peteallenm/edrumulus/hardware/prototype_petea_smd/edrumulus.kicad_pcb

## KiCad design hardware/prototype_petea_smd/edrumulus.kicad_pcb (2024-10-21)

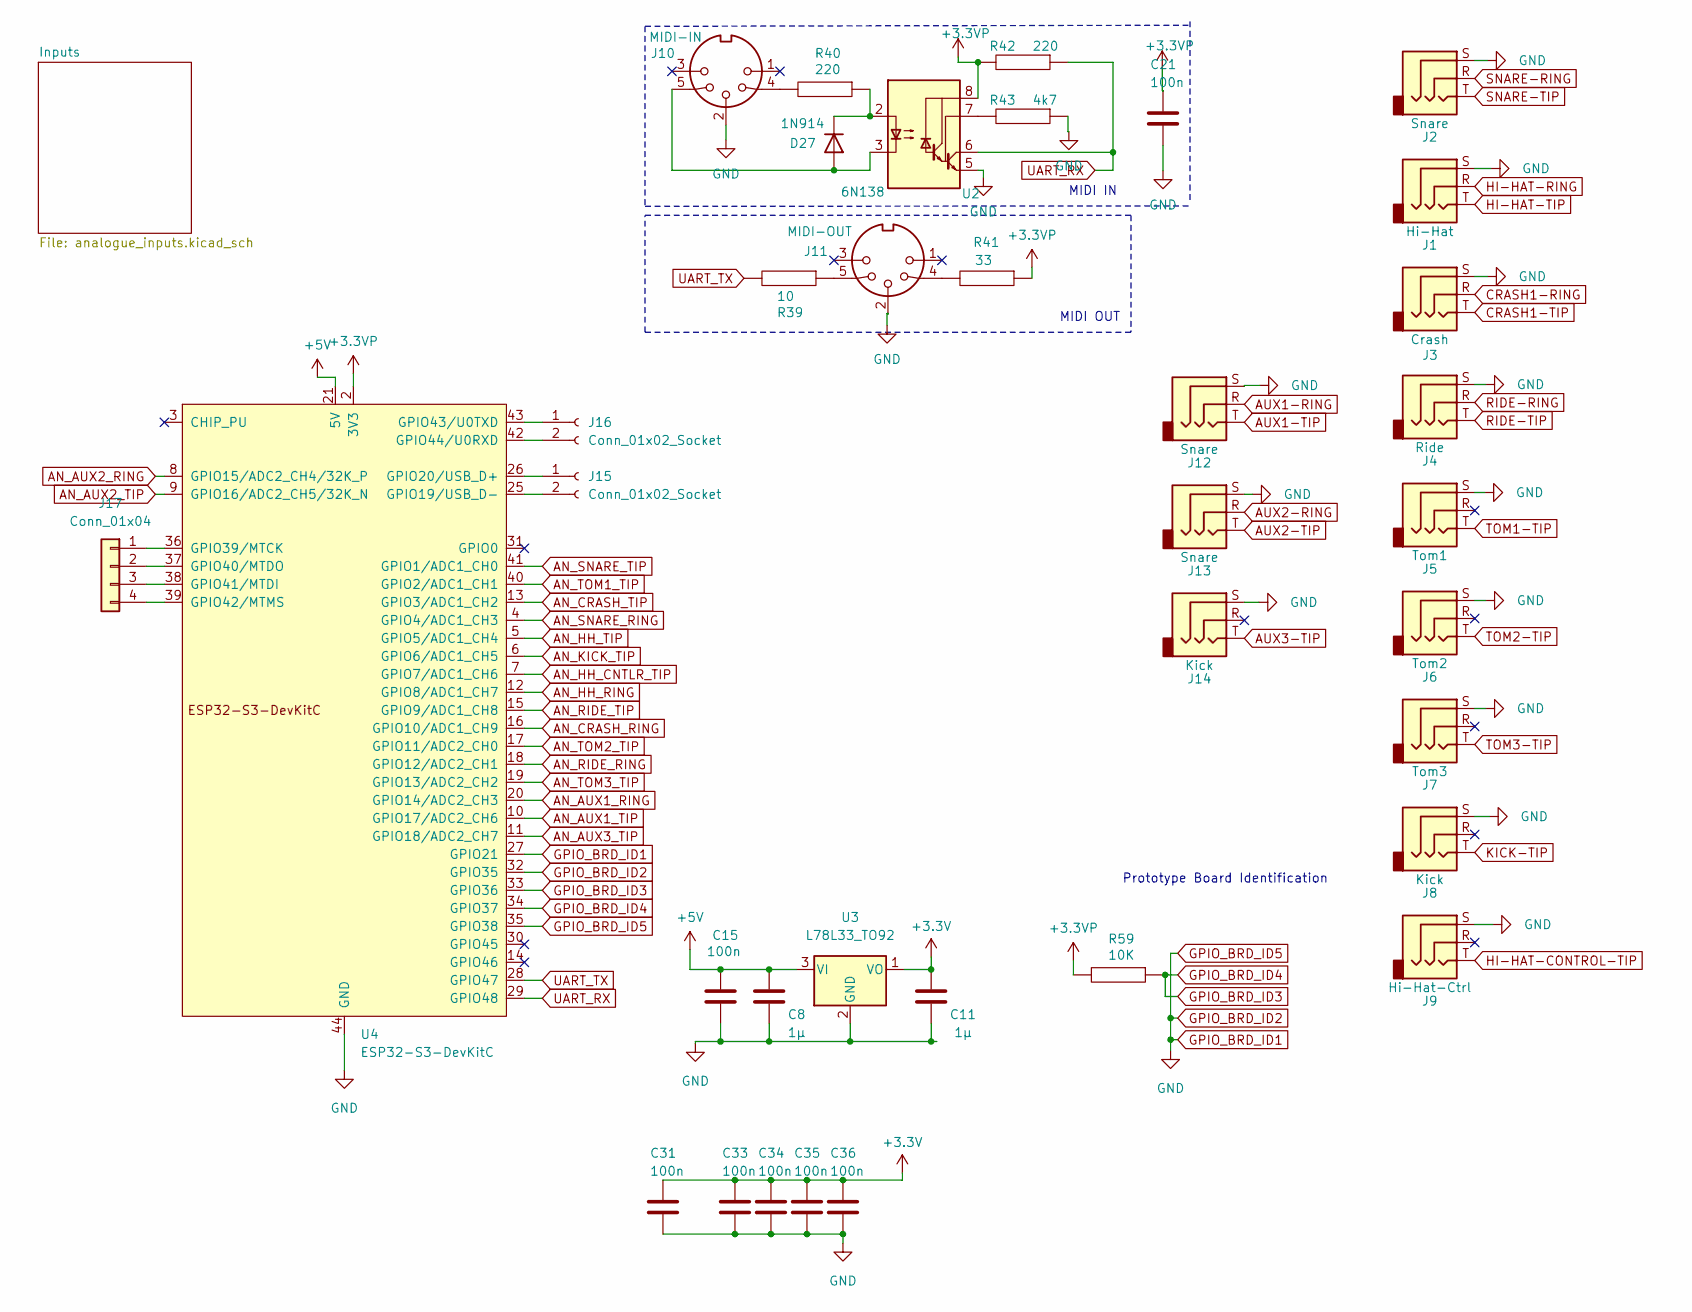
[picture p1: schematic edrumulus.kicad_sch, Edrumulus Prototype 7 (ESP32 S3)]

Parts:
C8, C11: 1µ; C_1206_3216Metric
C15, C21, C31, C33, C34, C35, C36: 100n; C_1206_3216Metric
D27: 1N914; D_DO-35_SOD27_P7.62mm_Horizontal
J1: Hi-Hat; Jack_6.35mm_Neutrik_NMJ6HCD2_Horizontal
J2, J12, J13: Snare; Jack_6.35mm_Neutrik_NMJ6HCD2_Horizontal
J3: Crash; Jack_6.35mm_Neutrik_NMJ6HCD2_Horizontal
J4: Ride; Jack_6.35mm_Neutrik_NMJ6HCD2_Horizontal
J5: Tom1; Jack_6.35mm_Neutrik_NMJ6HCD2_Horizontal
J6: Tom2; Jack_6.35mm_Neutrik_NMJ6HCD2_Horizontal
J7: Tom3; Jack_6.35mm_Neutrik_NMJ6HCD2_Horizontal
J8, J14: Kick; Jack_6.35mm_Neutrik_NMJ6HCD2_Horizontal
J9: Hi-Hat-Ctrl; Jack_6.35mm_Neutrik_NMJ6HCD2_Horizontal
J10: MIDI-IN; DIN-5
J11: MIDI-OUT; DIN-5
J15, J16: Conn_01x02_Socket; PinHeader_1x02_P2.54mm_Vertical
J17: Conn_01x04; PinHeader_1x04_P2.54mm_Vertical
R39: 10; R_1206_3216Metric
R40, R42: 220; R_1206_3216Metric
R41: 33; R_1206_3216Metric
R43: 4k7; R_1206_3216Metric
R59: 10K; R_1206_3216Metric
U2: 6N138; DIP-8_W7.62mm_Socket
U3: L78L33_TO92; TO-92_Inline
U4: ESP32-S3-DevKitC

Connections:
+3.3V: C11.1, C31.1, C33.1, C34.1, C35.1, C36.1, U3.1 (VO); also elsewhere on the board
+3.3VP: C21.1, R41.1, R42.2, R59.2, U2.8 (VCC), U4.1 (3V3), U4.2 (3V3)
+5V: C8.1, C15.1, U3.3 (VI), U4.21 (5V)
AN_AUX1_RING: U4.20 (GPIO14/ADC2_CH3); also elsewhere on the board
AN_AUX1_TIP: U4.10 (GPIO17/ADC2_CH6); also elsewhere on the board
AN_AUX2_RING: U4.8 (GPIO15/ADC2_CH4/32K_P); also elsewhere on the board
AN_AUX2_TIP: U4.9 (GPIO16/ADC2_CH5/32K_N); also elsewhere on the board
AN_AUX3_TIP: U4.11 (GPIO18/ADC2_CH7); also elsewhere on the board
AN_CRASH_RING: U4.16 (GPIO10/ADC1_CH9); also elsewhere on the board
AN_CRASH_TIP: U4.13 (GPIO3/ADC1_CH2); also elsewhere on the board
AN_HH_CNTLR_TIP: U4.7 (GPIO7/ADC1_CH6); also elsewhere on the board
AN_HH_RING: U4.12 (GPIO8/ADC1_CH7); also elsewhere on the board
AN_HH_TIP: U4.5 (GPIO5/ADC1_CH4); also elsewhere on the board
AN_KICK_TIP: U4.6 (GPIO6/ADC1_CH5); also elsewhere on the board
AN_RIDE_RING: U4.18 (GPIO12/ADC2_CH1); also elsewhere on the board
AN_RIDE_TIP: U4.15 (GPIO9/ADC1_CH8); also elsewhere on the board
AN_SNARE_RING: U4.4 (GPIO4/ADC1_CH3); also elsewhere on the board
AN_SNARE_TIP: U4.41 (GPIO1/ADC1_CH0); also elsewhere on the board
AN_TOM1_TIP: U4.40 (GPIO2/ADC1_CH1); also elsewhere on the board
AN_TOM2_TIP: U4.17 (GPIO11/ADC2_CH0); also elsewhere on the board
AN_TOM3_TIP: U4.19 (GPIO13/ADC2_CH2); also elsewhere on the board
AUX1-RING: J12.R; also elsewhere on the board
AUX1-TIP: J12.T; also elsewhere on the board
AUX2-RING: J13.R; also elsewhere on the board
AUX2-TIP: J13.T; also elsewhere on the board
AUX3-TIP: J14.T; also elsewhere on the board
CRASH1-RING: J3.R; also elsewhere on the board
CRASH1-TIP: J3.T; also elsewhere on the board
GPIO_BRD_ID1: C8.2, C11.2, C15.2, C21.2, C31.2, C33.2, C34.2, C35.2, C36.2, J1.S, J2.S, J3.S, J4.S, J5.S, J6.S, J7.S, J8.S, J9.S, J10.2, J11.2, J12.S, J13.S, J14.S, R43.1, U2.5 (GND), U3.2 (GND), U4.22 (GND), U4.23 (GND), U4.24 (GND), U4.27 (GPIO21), U4.32 (GPIO35), U4.35 (GPIO38), U4.44 (GND); also elsewhere on the board
GPIO_BRD_ID3: R59.1, U4.33 (GPIO36), U4.34 (GPIO37)
HI-HAT-CONTROL-TIP: J9.T; also elsewhere on the board
HI-HAT-RING: J1.R; also elsewhere on the board
HI-HAT-TIP: J1.T; also elsewhere on the board
KICK-TIP: J8.T; also elsewhere on the board
unnamed: D27.2 (A), J10.5, U2.3 (C2)
unnamed: D27.1 (K), R40.1, U2.2 (C1)
unnamed: J10.4, R40.2
unnamed: J11.4, R41.2
unnamed: J11.5, R39.1
unnamed: J15.1, U4.26 (GPIO20/USB_D+)
unnamed: J15.2, U4.25 (GPIO19/USB_D-)
unnamed: J16.1, U4.43 (GPIO43/U0TXD)
unnamed: J16.2, U4.42 (GPIO44/U0RXD)
unnamed: J17.1, U4.36 (GPIO39/MTCK)
unnamed: J17.2, U4.37 (GPIO40/MTDO)
unnamed: J17.3, U4.38 (GPIO41/MTDI)
unnamed: J17.4, U4.39 (GPIO42/MTMS)
unnamed: R43.2, U2.7 (VO1)
RIDE-RING: J4.R; also elsewhere on the board
RIDE-TIP: J4.T; also elsewhere on the board
SNARE-RING: J2.R; also elsewhere on the board
SNARE-TIP: J2.T; also elsewhere on the board
TOM1-TIP: J5.T; also elsewhere on the board
TOM2-TIP: J6.T; also elsewhere on the board
TOM3-TIP: J7.T; also elsewhere on the board
UART_RX: R42.1, U2.6 (VO2), U4.29 (GPIO48)
UART_TX: R39.2, U4.28 (GPIO47)

Notes on the sheet:
MIDI OUT
Prototype Board Identification
MIDI IN

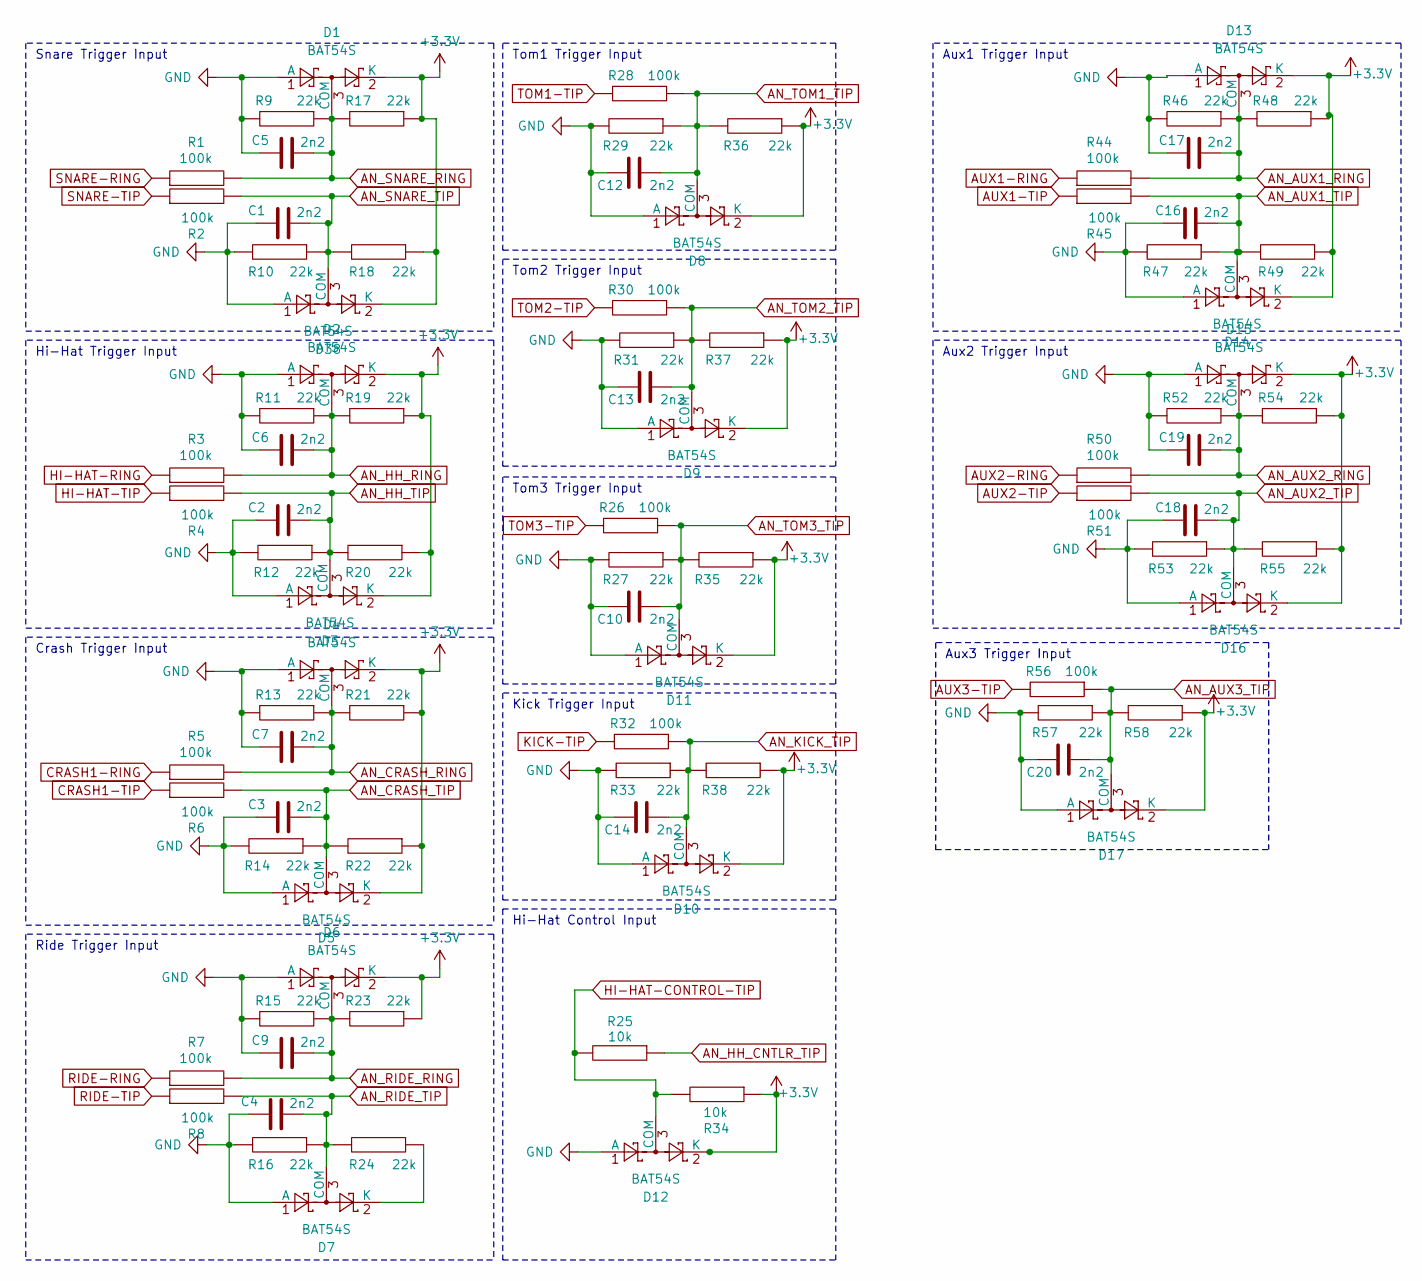
[picture p2: schematic analogue_inputs.kicad_sch]

Parts:
C1, C2, C3, C4, C5, C6, C7, C9, C10, C12, C13, C14, C16, C17, C18, C19, C20: 2n2; C_1206_3216Metric
D1, D2, D3, D4, D5, D6, D7, D8, D9, D10, D11, D12, D13, D14, D15, D16, D17, D38: BAT54S; SOT-23
R1, R2, R3, R4, R5, R6, R7, R8, R26, R28, R30, R32, R44, R45, R50, R51, R56: 100k; R_1206_3216Metric
R9, R10, R11, R12, R13, R14, R15, R16, R17, R18, R19, R20, R21, R22, R23, R24, R27, R29, R31, R33, R35, R36, R37, R38, R46, R47, R48, R49, R52, R53, R54, R55, R57, R58: 22k; R_1206_3216Metric
R25, R34: 10k; R_1206_3216Metric

Connections:
+3.3V: D1.2 (K), D2.2 (K), D3.2 (K), D4.2 (K), D5.2 (K), D6.2 (K), D8.2 (K), D9.2 (K), D10.2 (K), D11.2 (K), D12.2 (K), D13.2 (K), D14.2 (K), D15.2 (K), D16.2 (K), D17.2 (K), D38.2 (K), R17.1, R18.1, R19.1, R20.1, R21.1, R22.1, R23.1, R34.1, R35.1, R36.1, R37.1, R38.1, R48.1, R49.1, R54.1, R55.1, R58.1; also elsewhere on the board
AN_AUX1_RING: C17.1, D13.3 (COM), R44.2, R46.1, R48.2; also elsewhere on the board
AN_AUX1_TIP: C16.1, D14.3 (COM), R45.2, R47.1, R49.2; also elsewhere on the board
AN_AUX2_RING: C19.1, D15.3 (COM), R50.2, R52.1, R54.2; also elsewhere on the board
AN_AUX2_TIP: C18.1, D16.3 (COM), R51.2, R53.1, R55.2; also elsewhere on the board
AN_AUX3_TIP: R56.1; also elsewhere on the board
AN_CRASH_RING: C7.1, D4.3 (COM), R5.2, R13.1, R21.2; also elsewhere on the board
AN_CRASH_TIP: C3.1, D5.3 (COM), R6.2, R14.1, R22.2; also elsewhere on the board
AN_HH_CNTLR_TIP: R25.1; also elsewhere on the board
AN_HH_RING: C6.1, D2.3 (COM), R3.2, R11.1, R19.2; also elsewhere on the board
AN_HH_TIP: C2.1, D3.3 (COM), R4.2, R12.1, R20.2; also elsewhere on the board
AN_KICK_TIP: R32.1; also elsewhere on the board
AN_RIDE_RING: C9.1, D6.3 (COM), R7.2, R15.1, R23.2; also elsewhere on the board
AN_RIDE_TIP: C4.1, D7.3 (COM), R8.2, R16.1, R24.2; also elsewhere on the board
AN_SNARE_RING: C5.1, D1.3 (COM), R1.2, R9.1, R17.2; also elsewhere on the board
AN_SNARE_TIP: C1.1, D38.3 (COM), R2.2, R10.1, R18.2; also elsewhere on the board
AN_TOM1_TIP: C12.1, D8.3 (COM), R28.1, R29.1, R36.2; also elsewhere on the board
AN_TOM2_TIP: C13.1, D9.3 (COM), R30.1, R31.1, R37.2; also elsewhere on the board
AN_TOM3_TIP: C10.1, D11.3 (COM), R26.1, R27.1, R35.2; also elsewhere on the board
AUX1-RING: R44.1; also elsewhere on the board
AUX1-TIP: R45.1; also elsewhere on the board
AUX2-RING: R50.1; also elsewhere on the board
AUX2-TIP: R51.1; also elsewhere on the board
AUX3-TIP: R56.2; also elsewhere on the board
CRASH1-RING: R5.1; also elsewhere on the board
CRASH1-TIP: R6.1; also elsewhere on the board
GPIO_BRD_ID1: C1.2, C2.2, C3.2, C5.2, C6.2, C7.2, C9.2, C10.2, C12.2, C13.2, C14.2, C16.2, C17.2, C18.2, C19.2, C20.2, D1.1 (A), D2.1 (A), D3.1 (A), D4.1 (A), D5.1 (A), D6.1 (A), D8.1 (A), D9.1 (A), D10.1 (A), D11.1 (A), D12.1 (A), D13.1 (A), D14.1 (A), D15.1 (A), D16.1 (A), D17.1 (A), D38.1 (A), R9.2, R10.2, R11.2, R12.2, R13.2, R14.2, R15.2, R27.2, R29.2, R31.2, R33.2, R46.2, R47.2, R52.2, R53.2, R57.2; also elsewhere on the board
HI-HAT-CONTROL-TIP: D12.3 (COM), R25.2, R34.2; also elsewhere on the board
HI-HAT-RING: R3.1; also elsewhere on the board
HI-HAT-TIP: R4.1; also elsewhere on the board
KICK-TIP: R32.2; also elsewhere on the board
unnamed: C4.2, D7.1 (A), R16.2
unnamed: D7.2 (K), R24.1
unnamed: C14.1, D10.3 (COM), R33.1, R38.2
unnamed: C20.1, D17.3 (COM), R57.1, R58.2
RIDE-RING: R7.1; also elsewhere on the board
RIDE-TIP: R8.1; also elsewhere on the board
SNARE-RING: R1.1; also elsewhere on the board
SNARE-TIP: R2.1; also elsewhere on the board
TOM1-TIP: R28.2; also elsewhere on the board
TOM2-TIP: R30.2; also elsewhere on the board
TOM3-TIP: R26.2; also elsewhere on the board

Notes on the sheet:
Tom1 Trigger Input
Aux3 Trigger Input
Tom3 Trigger Input
Hi-Hat Trigger Input
Aux1 Trigger Input
Ride Trigger Input
Kick Trigger Input
Snare Trigger Input
Tom2 Trigger Input
Crash Trigger Input
Aux2 Trigger Input
Hi-Hat Control Input

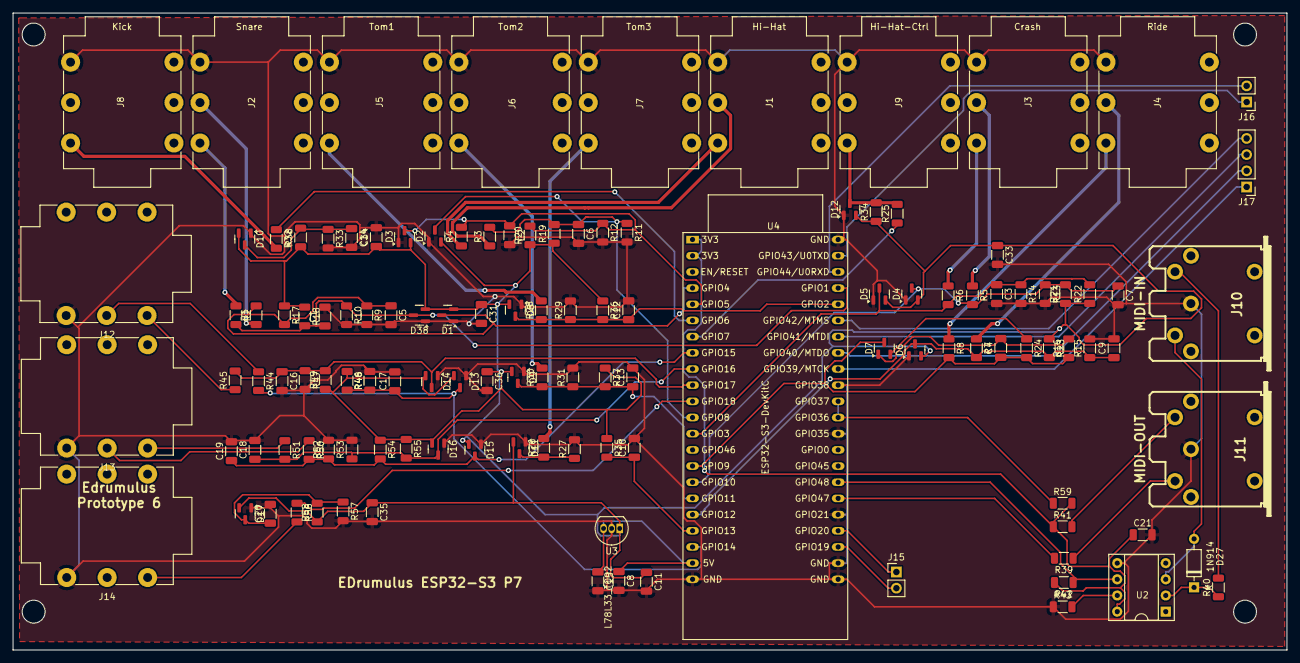
[picture p3: board edrumulus.kicad_pcb from above]

Board: 2 copper layers, 200.0 x 100.0 mm, 124 parts (0 on the bottom side), 61 nets.
