peteallenm/edrumulus/(commit log)

2024-10-20 Add first version of the SMD
    [analogue_inputs.kicad_sch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]
2024-10-21 Fix routing
    [edrumulus.kicad_pcb]
2024-10-21 Update gerbers
    [edrumulus-B_Cu.gbl, edrumulus-B_Mask.gbs, edrumulus-B_Paste.gbp, edrumulus-B_Silkscreen.gbo, edrumulus-Edge_Cuts.gm1, edrumulus-F_Cu.gtl, edrumulus-F_Mask.gts, edrumulus-F_Paste.gtp]
2024-10-23 rename to prototype_petea_smd
    [analogue_inputs.kicad_sch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]
2024-10-23 rename prototype
    [analogue_inputs.kicad_sch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]
2024-10-30 Fix the debug plot
    [GenUtils.cpp, GenUtils.h, edrumulus.ino]
